kev-cam/kestrel/layout/kestrel_pll_flat_extracted.cir

* cell kestrel_pll_top
.SUBCKT kestrel_pll_top
* device instance $1 r0 *1 0.505,-42.77 sky130_fd_pr__nfet_01v8
M$1 20 1 19 19 sky130_fd_pr__nfet_01v8 L=0.15U W=0.6U AS=0.15P AD=0.3P PS=1.7U
+ PD=2.2U
* device instance $2 r0 *1 4.505,-42.77 sky130_fd_pr__nfet_01v8
M$2 22 2 21 21 sky130_fd_pr__nfet_01v8 L=0.15U W=0.6U AS=0.15P AD=0.3P PS=1.7U
+ PD=2.2U
* device instance $3 r0 *1 8.505,-42.77 sky130_fd_pr__nfet_01v8
M$3 24 3 23 23 sky130_fd_pr__nfet_01v8 L=0.15U W=0.6U AS=0.15P AD=0.3P PS=1.7U
+ PD=2.2U
* device instance $4 r0 *1 12.765,-42.77 sky130_fd_pr__nfet_01v8
M$4 26 4 25 25 sky130_fd_pr__nfet_01v8 L=0.15U W=0.6U AS=0.15P AD=0.3P PS=1.7U
+ PD=2.2U
* device instance $5 r0 *1 16.765,-42.77 sky130_fd_pr__nfet_01v8
M$5 28 5 27 27 sky130_fd_pr__nfet_01v8 L=0.15U W=0.6U AS=0.15P AD=0.3P PS=1.7U
+ PD=2.2U
* device instance $6 r0 *1 20.765,-42.77 sky130_fd_pr__nfet_01v8
M$6 30 6 29 29 sky130_fd_pr__nfet_01v8 L=0.15U W=0.6U AS=0.15P AD=0.3P PS=1.7U
+ PD=2.2U
* device instance $7 r0 *1 25.025,-42.77 sky130_fd_pr__nfet_01v8
M$7 32 7 31 31 sky130_fd_pr__nfet_01v8 L=0.15U W=0.6U AS=0.15P AD=0.3P PS=1.7U
+ PD=2.2U
* device instance $8 r0 *1 29.025,-42.77 sky130_fd_pr__nfet_01v8
M$8 34 8 33 33 sky130_fd_pr__nfet_01v8 L=0.15U W=0.6U AS=0.15P AD=0.3P PS=1.7U
+ PD=2.2U
* device instance $9 r0 *1 33.025,-42.77 sky130_fd_pr__nfet_01v8
M$9 36 9 35 35 sky130_fd_pr__nfet_01v8 L=0.15U W=0.6U AS=0.15P AD=0.3P PS=1.7U
+ PD=2.2U
* device instance $10 r0 *1 37.285,-42.77 sky130_fd_pr__nfet_01v8
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
+ AD=1.02375P PS=4.595U PD=4.595U
* device instance $125 r0 *1 56.24,13.607 sky130_fd_pr__pfet_01v8
M$125 327 265 326 326 sky130_fd_pr__pfet_01v8 L=0.36U W=4.095U AS=1.02375P
+ AD=2.0475P PS=4.595U PD=9.19U
* device instance $126 r0 *1 59.21,13.607 sky130_fd_pr__pfet_01v8
M$126 329 266 328 328 sky130_fd_pr__pfet_01v8 L=0.36U W=4.095U AS=1.02375P
+ AD=1.02375P PS=8.69U PD=4.595U
* device instance $127 r0 *1 60.07,13.607 sky130_fd_pr__pfet_01v8
M$127 330 267 329 329 sky130_fd_pr__pfet_01v8 L=0.36U W=4.095U AS=1.02375P
+ AD=1.02375P PS=4.595U PD=4.595U
* device instance $128 r0 *1 60.93,13.607 sky130_fd_pr__pfet_01v8
M$128 331 268 330 330 sky130_fd_pr__pfet_01v8 L=0.36U W=4.095U AS=1.02375P
+ AD=2.0475P PS=4.595U PD=9.19U
* device instance $129 r0 *1 62.9,13.607 sky130_fd_pr__pfet_01v8
M$129 333 269 332 332 sky130_fd_pr__pfet_01v8 L=0.36U W=4.095U AS=1.02375P
+ AD=1.02375P PS=8.69U PD=4.595U
* device instance $130 r0 *1 63.76,13.607 sky130_fd_pr__pfet_01v8
M$130 334 270 333 333 sky130_fd_pr__pfet_01v8 L=0.36U W=4.095U AS=1.02375P
+ AD=1.02375P PS=4.595U PD=4.595U
* device instance $131 r0 *1 64.62,13.607 sky130_fd_pr__pfet_01v8
M$131 335 271 334 334 sky130_fd_pr__pfet_01v8 L=0.36U W=4.095U AS=1.02375P
+ AD=2.0475P PS=4.595U PD=9.19U
.ENDS kestrel_pll_top
