kev-cam/kestrel/sch/kes_vco_delay_cell.kicad_sch

## KiCad design sch/kes_vco_delay_cell.kicad_sch (2026-03-16)

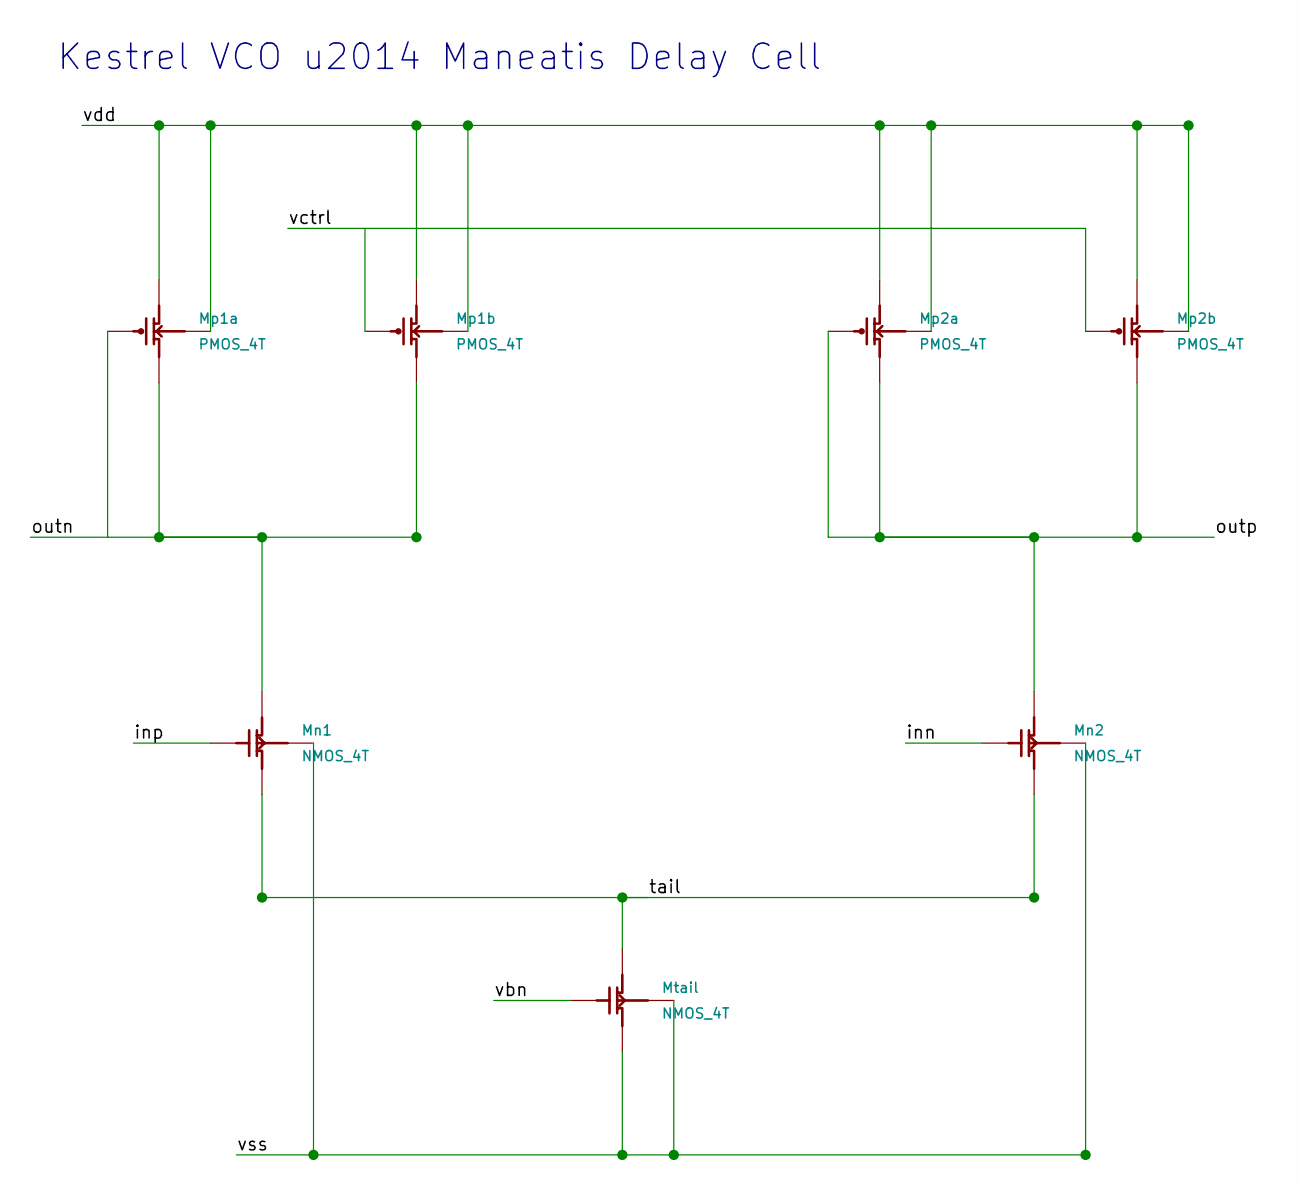
[picture p1: schematic kes_vco_delay_cell.kicad_sch]

Parts:
Mn1, Mn2: NMOS_4T
Mp1a, Mp1b, Mp2a, Mp2b: PMOS_4T
Mtail: NMOS_4T

Connections:
inn: Mn2.1 (G)
inp: Mn1.1 (G)
outn: Mn1.2 (D), Mp1a.1 (G), Mp1a.2 (D), Mp1b.2 (D)
outp: Mn2.2 (D), Mp2a.1 (G), Mp2a.2 (D), Mp2b.2 (D)
tail: Mn1.3 (S), Mn2.3 (S), Mtail.2 (D)
vbn: Mtail.1 (G)
vctrl: Mp1b.1 (G), Mp2b.1 (G)
vdd: Mp1a.3 (S), Mp1a.4 (B), Mp1b.3 (S), Mp1b.4 (B), Mp2a.3 (S), Mp2a.4 (B), Mp2b.3 (S), Mp2b.4 (B)
vss: Mn1.4 (B), Mn2.4 (B), Mtail.3 (S), Mtail.4 (B)

Notes on the sheet:
Kestrel VCO u2014 Maneatis Delay Cell
