kev-cam/kestrel/sim/opt/refit_params.yaml

data:
  '0.7': 476600000.0
  '0.9': 771700000.0
  '1.0': 772100000.0
  '1.1': 776800000.0
  '1.3': 777400000.0
  '1.5': 789400000.0
fit_quality:
  max_error_hz: 25509064.53951931
  n_points: 6
  rms_error_hz: 15514736.47150344
  vctrl_range:
  - 0.7
  - 1.5
linear:
  f0_hz: 404234693.8775512
  kvco_eff_hz_per_v: 298244897.9591838
polynomial:
  coefficients:
  - 2922906091.370658
  - -10615171017.645933
  - 12665323996.857899
  - -4185110678.0276318
  degree: 3
  description: f(Vctrl) = sum(coeff[i] * Vctrl^(deg-i))
