kev-cam/kestrel/(commit log)

2026-03-07 Usable IP.
    [Expired-Patents.csv]
2026-03-11 Add PLL design engine, Verilog-AMS emitter, and spec GUI
    - Design engine: computes divider, VCO gain, charge pump current,
    loop filter R/C1/C2 from user specs using standard CP-PLL methodology
    - Verilog-AMS emitter: generates behavioral models for VCO, PFD,
    charge pump, loop filter, divider, and top-level PLL
    - Tkinter GUI for spec entry with Design/Generate/Save buttons
    - CLI interface (kestrel gen / kestrel gui)
    - SI suffix parser for frequencies and times (e.g. 800M, 5ps)
2026-03-12 Add SPICE, behavioral, and KiCad schematic emitters with parameterized templates
    Add transistor-level SPICE emitter (Maneatis VCO, NAND PFD, cascode CP,
    TSPC divider), SVG schematic generator, and behavioral B-source model
    emitter driven by @PARAM@ templates. The behavioral emitter maps
    PLLDesign fields (kvco, r_filter, c1, c2, n_nom) to template
    placeholders and generates both .cir and .kicad_sch output. Wire all
    emitters into CLI and GUI.
2026-03-14 Add behavioral PLL simulation (ngspice/OpenVAF OSDI)
    Verilog-A models compiled via OpenVAF to OSDI for ngspice:
    - kes_vco.va: Van der Pol relaxation oscillator, kvco=707MHz/V effective
    - kes_cp.va: tanh-based charge pump, soft rail clamps
    - kes_lf.va: 2nd-order passive loop filter (R1-C1-C2)
    Mixed-signal testbench using XSPICE digital code models (d_dff,
    d_and, d_inverter, adc/dac_bridge) for PFD and div-by-64.
    Key ngspice workarounds documented in kes_run_beh.sp:
    - circbyline builds netlist inside .control (OSDI must load before parse)
    - XSPICE brackets only on vector ports (adc/dac_bridge), not scalar
    (d_dff, d_pullup, d_inverter)
    - .MODEL cards required for OSDI devices (N prefix)
    Co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
2026-03-16 Add transistor-level VCO (Xyce/sky130) and optimization framework
    - Xyce testbench with sky130 BSIM4 binned models (nfet/pfet bin 6 + 161)
    - Maneatis delay cell: 4-stage differential ring with self-biased replica
    - Sizing optimization via Nelder-Mead (scipy): 112 evals, cost 0.363→0.249
    - Pluggable backends: Xyce/Spectre simulators, Calibre/Magic/Quantus extractors
    - Behavioral model refit (polynomial f(Vctrl)) matching transistor curve ±3.3%
    - KiCad schematic of delay cell with project file
    Transistor VCO range: 477–789 MHz (Vctrl 0.7–1.5V), kvco_eff ≈ 298 MHz/V
    [kes_vco_delay_cell.kicad_sch, opt_log.csv]
2026-03-16 Update plan to reflect current status, add HTML documentation
    - Kestrel-Plan.md: updated project structure to match reality, added
    current status section with working/planned items, milestone checkboxes,
    transistor-level VCO findings, optimization framework usage
    - Removed dead references to files that don't exist (layout/, pdk/, etc.)
    - docs/index.html: browsable project docs with architecture diagrams,
    simulation guides, optimization details, results tables, and external links
2026-03-18 Add GDSII layout generation, extraction, and parasitic analysis (M4)
    gdsfactory-based layout generator (gds_gen.py) producing sky130
    transistor-level layout for the complete PLL: VCO delay cell, bias,
    charge pump, PFD, loop filter, and divider. Parameterized NFET/PFET
    primitives with full contact stacks (DIFF→LICON→LI→MCON→MET1→VIA1→MET2).
    KLayout netlist extraction (extract.py) using MOS3Transistor device
    recognition with correct P=gate layer mapping. Flat extraction for
    cross-hierarchy VIA1 connectivity. MET2 for intra-cell inter-row
    routing, MET3 for inter-stage and feedback — eliminates S/D shorts
    from MET2 polygon merging.
    Parasitic R/C estimation (parasitics.py) from wi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
2026-03-18 Update plan with layout generation docs and usage guide
    Document the layout flow: quick-start commands, metal layer
    discipline (MET1 local / MET2 intra-cell / MET3 inter-stage),
    extraction details (MOS3 with P=gate, flat extraction), parasitic
    feedback mechanism, and key results table. Update M4 milestone
    checklist and add gdsfactory/klayout to dependencies.
2026-03-18 Add SPICE-in-the-loop VCO frequency tuning
    Closes the design→layout→simulate loop: generates a Xyce VCO
    testbench with sky130 BSIM4 models and layout parasitic C annotations,
    measures oscillation frequency from .MEASURE zero crossings, and
    adjusts VCO sizing with damped proportional correction.
    Starts from known-good sky130 sizing (W_tail=40u, W_diff=20u,
    W_load=10u) and scales tail current + load width while keeping
    the diff pair fixed (scaling diff pair adds gate cap faster than
    it adds transconductance, slowing the ring).
    Converges from 434 MHz to 583 MHz (−2.9% of 600 MHz target) in
    7 iterations, each running a full Xyce transient simulation.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
2026-03-28 Add IHP SG13G2 process support (kev-cam/kestrel#1)
    Design engine: sg13g2 process params (kpn=299uA/V², vtn=0.255V, 1.2V).
    SPICE emitter: inst_prefix field (M vs X) for subcircuit-based PDK models.
    VCO testbench: sim/kes_vco_xyce_sg13g2.cir targeting PSP 103.6 via IHP-Open-PDK.
2026-03-29 SG13G2 VCO running in Xyce with IHP PSP 103 models
    Full 360-param model card extracted from IHP-Open-PDK TT corner,
    converted to Xyce-native PSP103 (level=103). VCO oscillates
    640–1099 MHz across Vctrl=0.2–1.0V at 1.2V supply.
    Closes kev-cam/kestrel#1.
2026-03-31 Restructure kestrel as multi-generator plugin framework
    PLL becomes the built-in reference generator under generators/pll/.
    External plugins (like grail) register via KESTREL_PLUGINS env var.
    - Add plugin discovery system (plugins.py) — scans built-in
    generators/ and KESTREL_PLUGINS colon-separated paths
    - Extract shared process params to process.py (sky130, gf180, sg13g2)
    - Extract shared SVG primitives to schematic.py
    - Rewrite cli.py as generic dispatcher: kestrel pll gen ..., etc.
    - Rewrite gui.py with dynamic fields from active generator plugin
    - Move PLL engine + models to generators/pll/ with kestrel_plugin.py
    - Add pyproject.toml and __main__.py for python -m kestrel
    - Update al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
2026-07-02 Fix flat-layout package discovery in pyproject.toml
    setuptools auto-discovery failed with "Multiple top-level packages
    discovered in a flat-layout" because sch/, sim/, and layout/ sit beside
    the kestrel package, so `pip install` could not build a wheel. Restrict
    discovery to kestrel* so the package installs cleanly.
2026-11-11 Add IHP SG13G2 transistor-level path: bundled models, calibrated VCO, emitter fixes
    SG13G2 (IHP-Open-PDK, Apache-2.0):
    - sim/models/sg13g2_lv.lib: wrappers with IHP's sg13_lv_nmos/pmos
    "d g s b w= l= ng= m=" subcircuit interface (PDK default S/D areas)
    over the bundled Xyce-native PSP103 TT cards. IHP's own Xyce library
    needs the YPSP103_VA device stock Xyce lacks; the flattened cards carry
    the same 341 numeric parameters with the mos_tt multipliers evaluated.
    - process.py: model_files for sg13g2 (copied next to every generated
    netlist and .INCLUDEd in order) and a vco_calibration block measured
    on the generated VCO in Xyce: 844 MHz @ Vctrl 0.20 V to 517 MHz @
    0.50 V, Kvco ~ -1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
2026-11-12 SG13G2 closed loop: defined loop-filter start, acquisition estimate, measured limits
    Closing the loop on the generated SG13G2 PLL in Xyce (/32, 20 MHz ref ->
    640 MHz) showed two things the generator did not account for:
    - With no defined start the operating point parks Vctrl wherever the idle
    charge pump's leakage leaves it (1.2 V here, 0.77 V with the old broken
    pump). At 1.2 V this VCO sits on its 625 MHz Istart floor, 2.4 % below
    target, so the PFD phase ramp alone takes 2 us and the loop was still
    unlocked at the end of the transient.
    - Acquisition is slew-limited, not set by the linear lock time: the pump
    moves the filter at ~Icp/2/(C1+C2) while the PFD cycle-slips (0.34 V/u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
2026-11-12 Fix loop-filter output tap (SPICE, VAMS, OSDI): VCO must see the charge-pump node
    The emitted loop filter handed the VCO the voltage across C1 (`Rout mid
    out 1`; `V(vctrl) <+ V(mid)` in the Verilog-AMS emitter and in
    sim/kes_lf.va). That node is the pure integral of the pump current:
    the R1-C1 zero is invisible to the VCO, the loop is a double integrator
    with no phase margin, and it rings at
    sqrt(Icp*Kvco/(2*pi*N*(C1+C2))) without settling.
    Seen on the generated SG13G2 PLL in Xyce (/32, 20 MHz ref -> 640 MHz):
    frequency acquired within 1.3 us, then Vctrl ringing +/-17 mV at
    ~0.85 MHz (predicted 0.77 MHz) with +/-9 ns of phase error, undamped over
    3 us. The behavioral OSDI bench shows the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
2026-11-12 Testbench: release the reference after the divider runs; report the pump ripple step
    With the loop-filter tap fixed (dd8a8fb) the emitted SG13G2 testbench
    did not lock: the reference started at t = 0, its first edge set UP
    about 50 ns before the VCO (running from ~11 ns) and the divider could
    produce a feedback edge, and with the R1-C1 zero now visible that single
    pulse stepped the control node by Icp*R1 = 0.22 V -- from 0.2 V to 0 V
    within 25 ns. The VCO ran to 1.09 GHz, where the 2^n divider produces
    no edges, UP never reset and the loop sat at Vctrl = 0 V for the whole
    3 us. (The old tap survived the same race only because its pulse slewed
    C1 at 0.7 V/us.)
    kestrel_tb.sp now releases th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
2026-11-12 Verilog-AMS: event-driven logic, VCO schedules the delay to its next edge
    Behavioral models are Verilog-AMS with event-driven logic; a VCO must
    schedule the delay to its next edge from the control voltage, not
    integrate a computed frequency (the previous model ran a phase
    accumulator with idtmod and $bound_step, the PFD and divider were
    analog cross() machines).
    kestrel_vco.vams is now one process: the edge travelling round the
    n_stages ring reads V(vctrl) on entering each stage, waits that stage's
    delay td_nom/(1 + s_td*(V - vctrl_nom)) (td_nom = 1/(2 N f_center),
    s_td = Kvco/f_center) and toggles the output once round, so the
    simulator only lands on the edges. kestrel_pfd.vams and
    kestre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
2026-11-12 stat-sim: nvc event-driven PLL model with timing variability
    New emitter kestrel/generators/pll/models/statsim.py (wired into
    `kestrel pll gen`): the nvc runtime form of the Verilog-AMS PLL, in the
    style of stat-sim's nvcgen.py -- VHDL entities on stat-sim's prob_load
    discipline (kestrel_vco_pl, kestrel_pfd_pl, kestrel_divider_pl,
    kestrel_cp_lf_pl, kestrel_pll_statsim), a measuring testbench and
    run_statsim.sh.
    Fully event-driven: the charge pump + R1-C1/C2 filter is its exact
    closed form between pump events (the drop across R1 relaxes to
    Icp*R1*C1/(C1+C2) with tau = R1*C1*C2/(C1+C2), the C1 node integrates
    it), so the control voltage is evaluated exactly at every VCO stage
    edge and no anal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
2026-11-12 ngspice: event-driven VCO (d_osc) everywhere, Van der Pol retired, generated bench
    sim/kes_tb_beh.sp uses the XSPICE d_osc VCO (every edge scheduled from
    Vctrl through a frequency table) instead of the OSDI Van der Pol
    oscillator, which integrated a frequency; sim/kes_vco.va is removed.
    The plain netlist never loaded its OSDI models (no pre_osdi, module
    names used as model names) and the hand-picked filter (R1 = 20 kOhm)
    gave a 2 V ripple step once the tap was right; it now loads kes_cp /
    kes_lf itself and uses the engine's sky130 loop values and VCO law
    (667 MHz-1.33 GHz over 0-1.8 V), /32 at 25 MHz: lock at 799.9 MHz,
    Vctrl = 0.360 V, settled by 0.28 us, 0.6 s of ngspice (11.7 s before).
    T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
2026-11-12 SG13G2: re-calibrate the VCO on the PDK's PSP103 (VACASK through vamos)
    Decision: the PDK's Verilog-A PSP103, as VACASK and ngspice run it, is the
    reference; Xyce's built-in level-103 on the flattened cards runs the
    generated ring ~45 % slow.
    process.py: vco_calibration measured on VACASK (50 mV steps): 1579 MHz at
    0 V, linear window 0.15-0.45 V (1299 -> 812 MHz), least-squares Kvco
    -1.634 GHz/V with f_nom 1044 MHz at 0.30 V (residuals < 1.3 %), minimum
    733 MHz at 0.55 V, 965 MHz floor; the emitted divider counts /32 to
    1.8 GHz input (div_fmax >= f_vctrl0).
    engine.py: place the spec's centre frequency on the calibrated line
    (vctrl_nom = cal point + (f_center - f_nom)/kvco, clamped to the w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
